ehntoo/CANtankerous/cantankerous.kicad_pcb

## KiCad design cantankerous.kicad_pcb (2020-12-21)

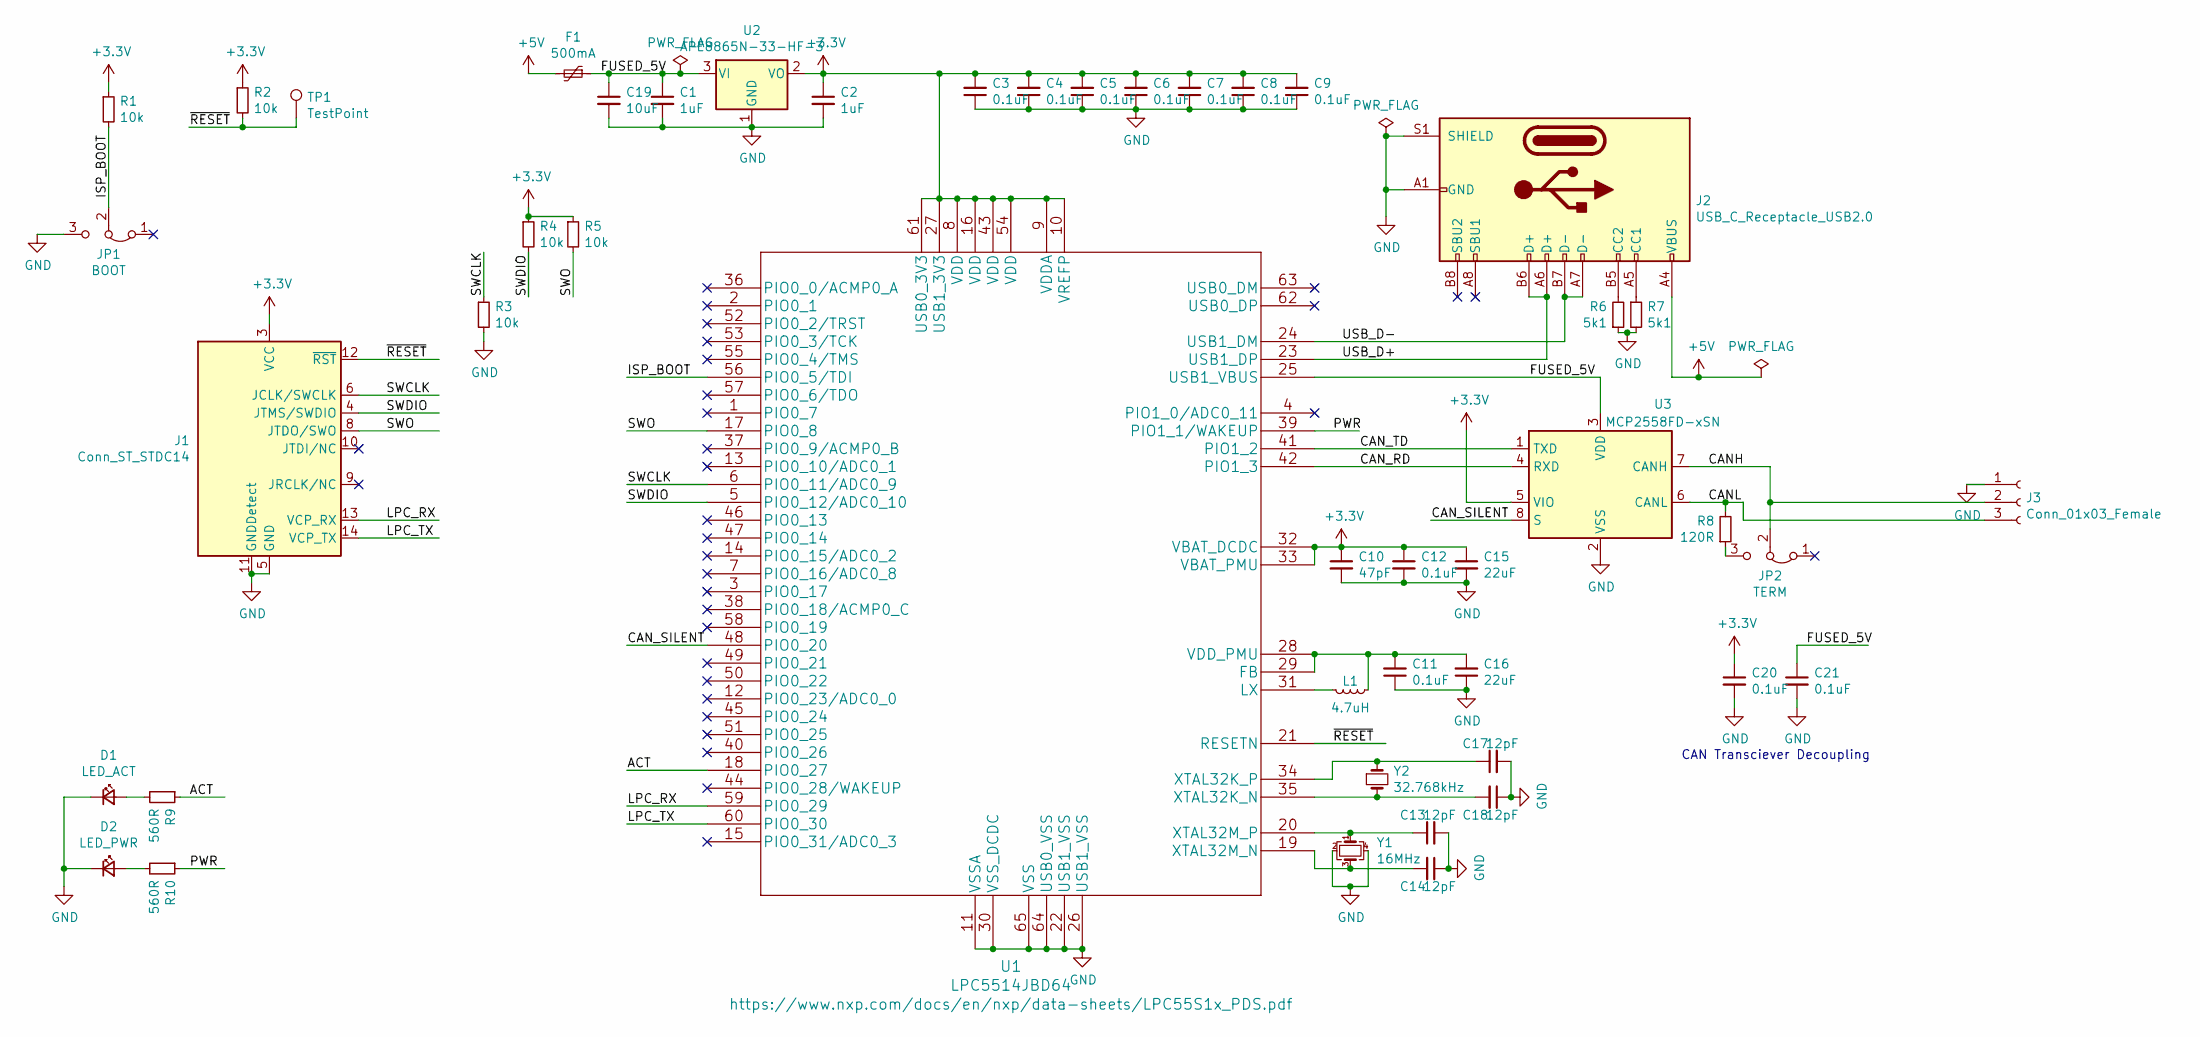
[picture p1: schematic cantankerous.sch]

Parts:
C1, C2: 1uF; C_0603_1608Metric_Pad1.08x0.95mm_HandSolder
C3, C4, C5, C6, C7, C8, C9, C11, C12, C20, C21: 0.1uF; C_0402_1005Metric_Pad0.74x0.62mm_HandSolder
C10: 47pF; C_0402_1005Metric_Pad0.74x0.62mm_HandSolder
C13, C14, C17, C18: 12pF; C_0402_1005Metric_Pad0.74x0.62mm_HandSolder
C15, C16: 22uF; C_0805_2012Metric_Pad1.18x1.45mm_HandSolder
C19: 10uF; C_0805_2012Metric_Pad1.18x1.45mm_HandSolder
D1: LED_ACT; D_0603_1608Metric_Pad1.05x0.95mm_HandSolder
D2: LED_PWR; D_0603_1608Metric_Pad1.05x0.95mm_HandSolder
F1: 500mA; Fuse_0805_2012Metric_Pad1.15x1.40mm_HandSolder
J1: Conn_ST_STDC14; PinHeader_2x07_P1.27mm_Vertical_SMD
J2: USB_C_Receptacle_USB2.0; USB_C_Receptacle_HRO_TYPE-C-31-M-12
J3: Conn_01x03_Female; TerminalBlock_Phoenix_MKDS-1,5-3_1x03_P5.00mm_Horizontal
JP1: BOOT; PinHeader_1x03_P2.54mm_Vertical
JP2: TERM; PinHeader_1x03_P2.54mm_Vertical
L1: 4.7uH; L_0805_2012Metric_Pad1.15x1.40mm_HandSolder
R1, R2, R3, R4, R5: 10k; R_0402_1005Metric_Pad0.72x0.64mm_HandSolder
R6, R7: 5k1; R_0402_1005Metric_Pad0.72x0.64mm_HandSolder
R8: 120R; R_0603_1608Metric_Pad0.98x0.95mm_HandSolder
R9, R10: 560R; R_0402_1005Metric_Pad0.72x0.64mm_HandSolder
TP1: TestPoint; TestPoint_Pad_D2.0mm
U1: LPC5514JBD64
U2: APE8865N-33-HF-3; SOT-23
U3: MCP2558FD-xSN; SOIC-8_3.9x4.9mm_P1.27mm
Y1: 16MHz; Crystal_SMD_3225-4Pin_3.2x2.5mm
Y2: 32.768kHz; Crystal_DS26_D2.0mm_L6.0mm_Horizontal

Connections:
+3V3: C2.1, C3.2, C4.2, C5.2, C6.2, C7.2, C8.2, C9.2, C10.1, C12.1, C15.1, C20.1, J1.3 (VCC), R1.1, R2.1, R4.1, R5.1, U1.8 (VDD), U1.9 (VDDA), U1.10 (VREFP), U1.16 (VDD), U1.27 (USB1_3V3), U1.32 (VBAT_DCDC), U1.33 (VBAT_PMU), U1.43 (VDD), U1.54 (VDD), U1.61 (USB0_3V3), U2.2 (VO), U3.5 (VIO)
+5V: F1.2, J2.A4 (VBUS), J2.A9 (VBUS), J2.B4 (VBUS), J2.B9 (VBUS)
/ACT: R9.1, U1.18 (PIO0_27)
/CANH: J3.2, JP2.2 (C), U3.7 (CANH)
/CANL: J3.3, R8.2, U3.6 (CANL)
/CAN_RD: U1.42 (PIO1_3), U3.4 (RXD)
/CAN_SILENT: U1.48 (PIO0_20), U3.8 (S)
/CAN_TD: U1.41 (PIO1_2), U3.1 (TXD)
/FUSED_5V: C1.1, C19.1, C21.1, F1.1, U1.25 (USB1_VBUS), U2.3 (VI), U3.3 (VDD)
/ISP_BOOT: JP1.2 (C), R1.2, U1.56 (PIO0_5/TDI)
/LPC_RX: J1.13 (VCP_RX), U1.59 (PIO0_29)
/LPC_TX: J1.14 (VCP_TX), U1.60 (PIO0_30)
/PWR: R10.1, U1.39 (PIO1_1/WAKEUP)
/SWCLK: J1.6 (JCLK/SWCLK), R3.1, U1.6 (PIO0_11/ADC0_9)
/SWDIO: J1.4 (JTMS/SWDIO), R4.2, U1.5 (PIO0_12/ADC0_10)
/SWO: J1.8 (JTDO/SWO), R5.2, U1.17 (PIO0_8)
/USB_D+: J2.A6 (D+), J2.B6 (D+), U1.23 (USB1_DP)
/USB_D-: J2.A7 (D-), J2.B7 (D-), U1.24 (USB1_DM)
/~RESET: J1.12 (~RST), R2.2, TP1.1, U1.21 (RESETN)
GND: C1.2, C2.2, C3.1, C4.1, C5.1, C6.1, C7.1, C8.1, C9.1, C10.2, C11.1, C12.2, C13.2, C14.1, C15.2, C16.1, C17.2, C18.1, C19.2, C20.2, C21.2, D1.1 (K), D2.1 (K), J1.5 (GND), J1.7 (GND), J1.11 (GNDDetect), J2.A1 (GND), J2.A12 (GND), J2.B1 (GND), J2.B12 (GND), J2.S1 (SHIELD), J3.1, JP1.3 (B), R3.2, R6.1, R7.2, U1.11 (VSSA), U1.22 (USB1_VSS), U1.26 (USB1_VSS), U1.30 (VSS_DCDC), U1.64 (USB0_VSS), U1.65 (VSS), U2.1 (GND), U3.2 (VSS), Y1.2, Y1.4
unnamed: C11.2, C16.2, L1.2, U1.28 (VDD_PMU), U1.29 (FB)
unnamed: C13.1, U1.20 (XTAL32M_P), Y1.1
unnamed: C14.2, U1.19 (XTAL32M_N), Y1.3
unnamed: C17.1, U1.34 (XTAL32K_P), Y2.1
unnamed: C18.2, U1.35 (XTAL32K_N), Y2.2
unnamed: D1.2 (A), R9.2
unnamed: D2.2 (A), R10.2
unnamed: J2.A5 (CC1), R7.1
unnamed: J2.B5 (CC2), R6.2
unnamed: JP2.3 (B), R8.1
unnamed: L1.1, U1.31 (LX)

Notes on the sheet:
CAN Transciever Decoupling

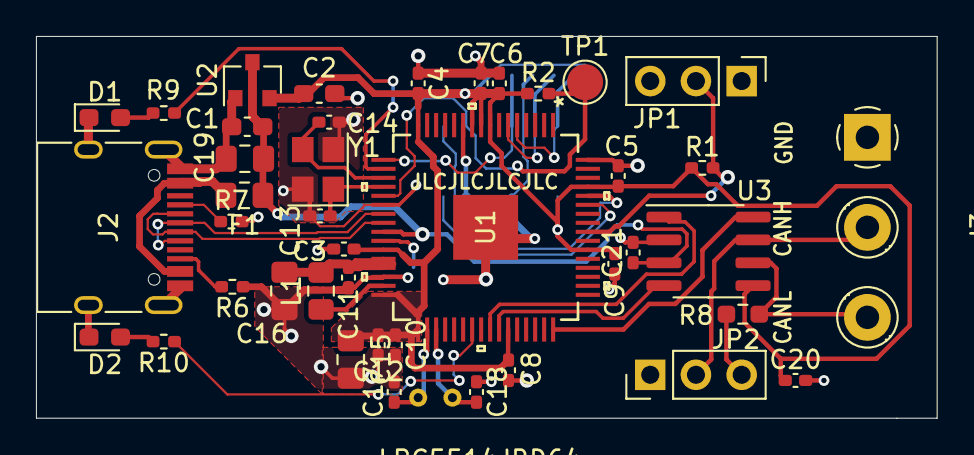
[picture p2: board cantankerous.kicad_pcb from above]

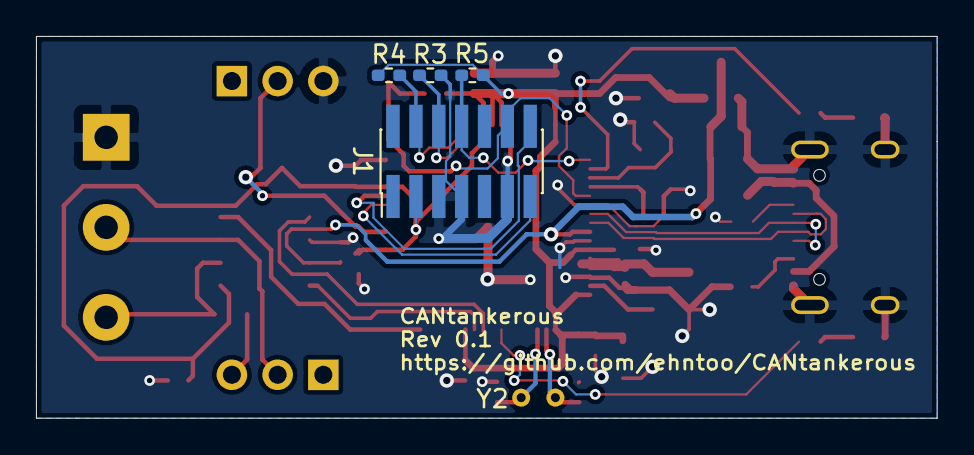
[picture p3: board cantankerous.kicad_pcb from below]

Board: 2 copper layers, 50.0 x 21.2 mm, 46 parts (5 on the bottom side), 31 nets.
