ehntoo/CANtankerous/(commit log)

2020-12-03 Initial Commit
    Pulled in symbols/footprints from the NXP Ultra Librarian file.
    [cantankerous.kicad_pcb, cantankerous.sch]
2020-12-05 Well, that was a lot of work. Rev 0.1
    [cantankerous-B_Cu.gbr, cantankerous-B_Mask.gbr, cantankerous-B_Paste.gbr, cantankerous-B_SilkS.gbr, cantankerous-Edge_Cuts.gbr, cantankerous-F_Cu.gbr, cantankerous-F_Mask.gbr, cantankerous-F_Paste.gbr]
2020-12-05 Add r01 production gerbers
2020-12-05 Add license - Solderpad 2.1
2020-12-05 Ignore some kicad temp files
2020-12-05 Update L1 footprint and value to fix units
    [cantankerous.kicad_pcb, cantankerous.sch]
2020-12-18 Initial design revisions from r0.1
    Actually connect VCC to the LPC5514 DCDC converter input (lol)
    Add decoupling caps to CAN transciever (layout not presently ideal)
    Rearrange activity LED trace to improve ground plane continuity
    [cantankerous.kicad_pcb, cantankerous.sch]
2020-12-20 Significant board layout revisions
    Clean up a number of current return paths for the high-speed USB
    and CAN-FD signals
    [cantankerous.kicad_pcb]
2020-12-21 New DCDC converter layout
    [cantankerous.kicad_pcb]
